PepeTheFroggie/EspCopter32/NewCode/readme.md

Schematic & description see:
https://github.com/PepeTheFroggie/EspCopter32/tree/master

Uses webpage PID setting.

Base for esp32-camcopter with built in wifi FPV. Unfinished.

For UDP transmitter see https://github.com/PepeTheFroggie/ESP32CAM_RCTANK/tree/master/ESP32webCAM_UDP/espnow_UDP_TX

Serial output options:
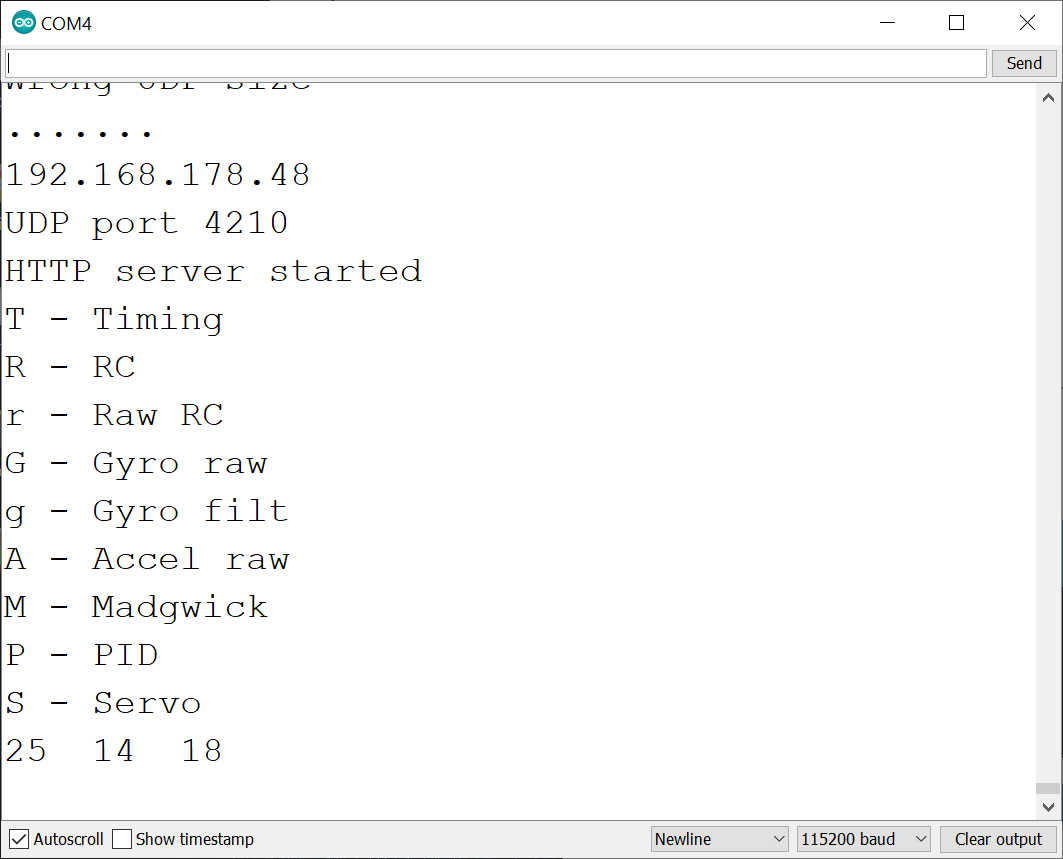
[picture p5: NewCode/serial.png]
serial


Serial Gyro Plot:
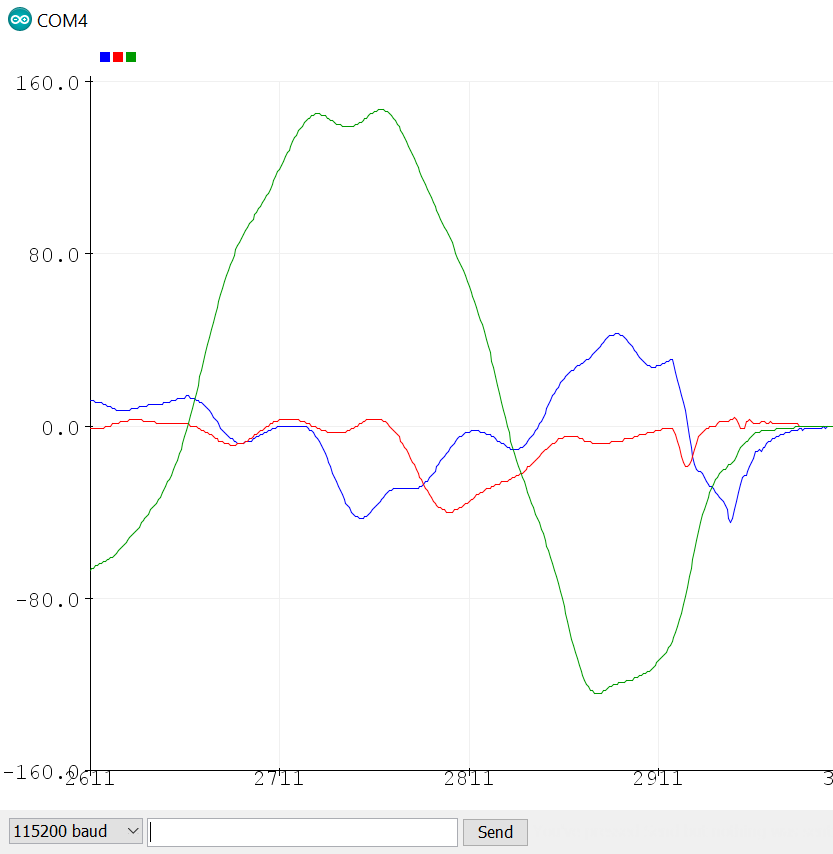
[picture p6: NewCode/gyroplot.png]
gyro


Webbased PID settings:
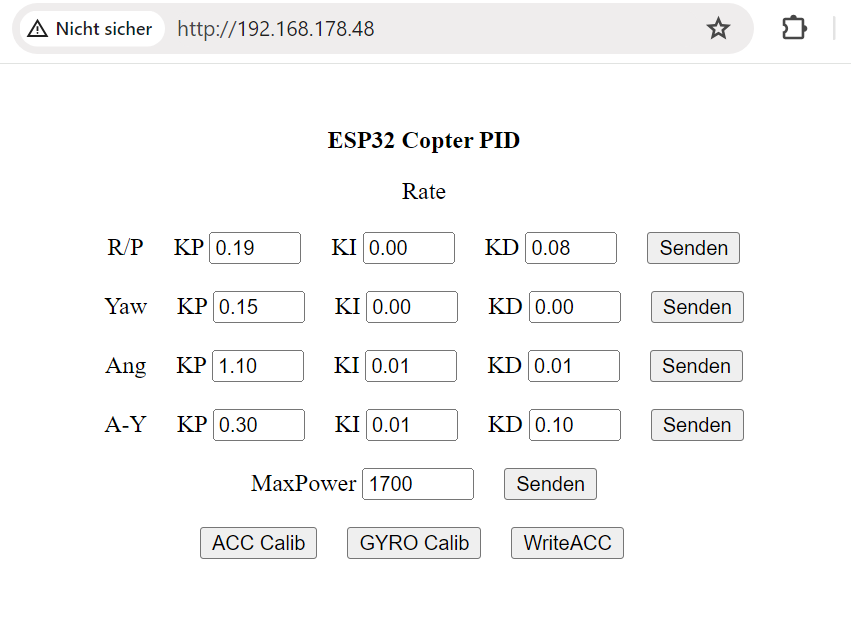
[picture p7: NewCode/web.png]
Web
