PepeTheFroggie/EspCopter32/DSC02375.jpg

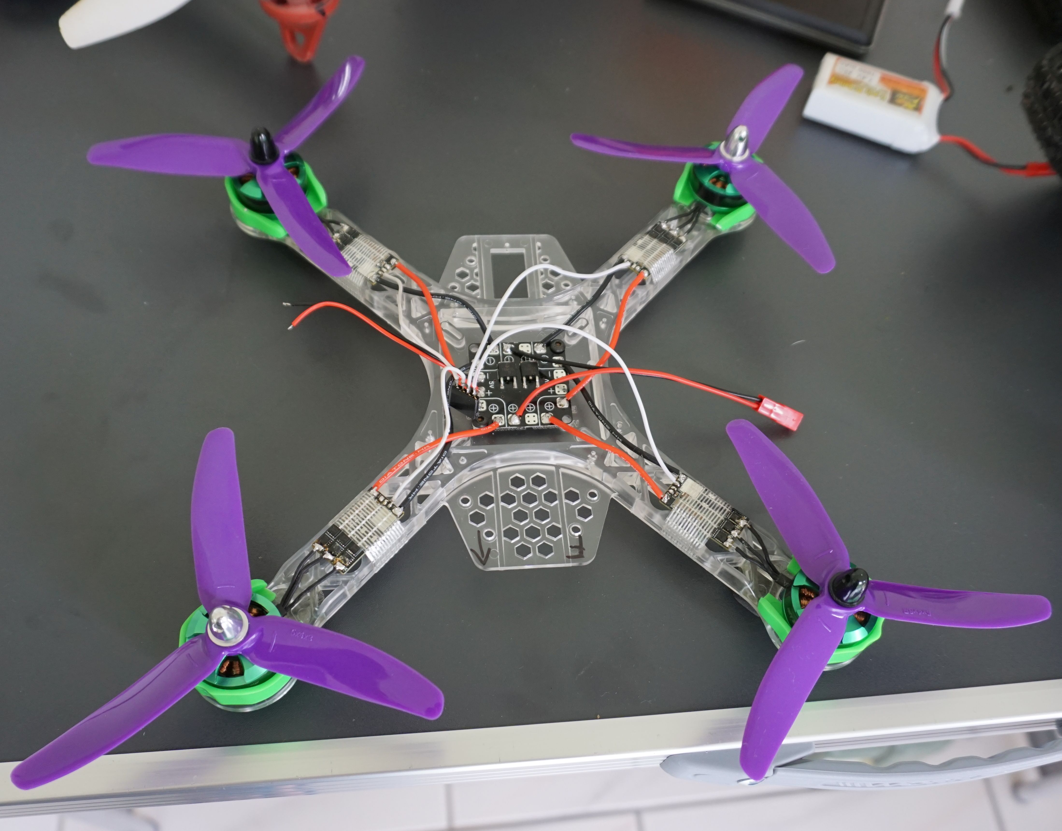
DSC02375.jpg
