PepeTheFroggie/EspCopter32/(threads)

Thread 2 (2020-01-01):

compiling issue

parthasarathy0077, 2020-01-01:
I'm a complete noob. I'm having a hard time in compiling in arduino IDE. Help out..

PepeTheFroggie, 2022-12-22:
No

Closed 2022-12-22.
