PepeTheFroggie/EspCopter32/NewCode/MPU6050.ino

#include <Wire.h>

#define MPU6050_ADDRESS 0x68 
  #define SMPLRT_DIV 0
  #define DLPF_CFG   4

#define ACCRESO 4096
int16_t gyroADC[3];
int16_t accADC[3];

#define ACC_ORIENTATION(X, Y, Z)  {accADC[PITCH] = -X; accADC[ROLL]   = Y;  accADC[YAW]  =  Z;}
#define GYRO_ORIENTATION(X, Y, Z) {gyroADC[ROLL] =  Y; gyroADC[PITCH] = -X; gyroADC[YAW] = -Z;}

void i2cRead(uint8_t Address, uint8_t Register, uint8_t Nbytes, uint8_t* Data) 
{
  Wire.beginTransmission(Address);
  Wire.write(Register);
  Wire.endTransmission();

  Wire.requestFrom(Address, Nbytes);
  uint8_t index=0;
  while (Wire.available())
    Data[index++]=Wire.read();
}

void i2cWriteByte(uint8_t Address, uint8_t Register, uint8_t Data) 
{
  Wire.beginTransmission(Address);
  Wire.write(Register);
  Wire.write(Data);
  Wire.endTransmission();
}

#define ADDRESS 0x03
int calibratingG = CALSTEPS;
int calibratingA = 0;
int16_t gyroZero[3] = {0,0,0};
int16_t accZero[3] = {0,0,0};

// ****************
// GYRO common part
// ****************
void GYRO_Common() 
{
  static int32_t g[3];
  uint8_t axis, tilt=0;

  if (calibratingG>0) 
  {
    for (axis = 0; axis < 3; axis++) 
    {
      // Reset g[axis] at start of calibration
      if (calibratingG == CALSTEPS) g[axis]=0;
      // Sum up 512 readings
      g[axis] += gyroADC[axis];
      // Clear global variables for next reading
      gyroADC[axis]=0;
      gyroZero[axis]=0;
      if (calibratingG == 1) 
      {
        if (g[axis]>=0) g[axis] += CALSTEPS/2;
        else            g[axis] -= CALSTEPS/2;
        gyroZero[axis] = g[axis]/CALSTEPS;
        Serial.print(gyroZero[axis]); 
        if (axis==2) Serial.println(); 
        else         Serial.print("  ");
      }
    }
    calibratingG--;
  }

  for (axis = 0; axis < 3; axis++)
    gyroADC[axis] = gyroADC[axis] - gyroZero[axis];
}

// ****************
// ACC common part
// ****************

void readacc()
{
  accZero[0] = EEPROM.readShort(0);
  accZero[1] = EEPROM.readShort(2);
  accZero[2] = EEPROM.readShort(6);  
}
void storeacc()
{
  EEPROM.writeShort(0, accZero[0]);
  EEPROM.writeShort(2, accZero[1]);
  EEPROM.writeShort(6, accZero[2]);
  EEPROM.commit();      
}

void ACC_Common() 
{
  static int32_t a[3];
  
  if (calibratingA>0) 
  {
    for (uint8_t axis = 0; axis < 3; axis++) 
    {
      // Reset a[axis] at start of calibration
      if (calibratingA == CALSTEPS) a[axis]=0;
      // Sum up 512 readings
      a[axis] += accADC[axis];
      // Clear global variables for next reading
      accADC[axis]=0;
      accZero[axis]=0;
    }
    // Calculate average, shift Z down by acc_1G and store values in EEPROM at end of calibration
    if (calibratingA == 1) 
    {
      if (a[0] >= 0) a[0] += CALSTEPS/2; else a[0] -= CALSTEPS/2;
      if (a[1] >= 0) a[1] += CALSTEPS/2; else a[1] -= CALSTEPS/2;
      if (a[2] >= 0) a[2] += CALSTEPS/2; else a[2] -= CALSTEPS/2;
      accZero[0] = a[0]/CALSTEPS;
      accZero[1] = a[1]/CALSTEPS;
      accZero[2] = a[2]/CALSTEPS - ACCRESO;   
      Serial.print(accZero[0]); Serial.print("  "); 
      Serial.print(accZero[1]); Serial.print("  "); 
      Serial.print(accZero[2]); Serial.println();
    }
    calibratingA--;
  }
  accADC[0] -=  accZero[0];
  accADC[1] -=  accZero[1];
  accADC[2] -=  accZero[2];
}

uint8_t rawADC[14];

void GyroAcc_getADC ()
{
  // 0x3B=6 gyro, 0x41=2 temp, 0x43=6 acc
  i2cRead(MPU6050_ADDRESS, 0x3B,14,rawADC);
  ACC_ORIENTATION( ((rawADC[0]<<8) | rawADC[1]) ,
                   ((rawADC[2]<<8) | rawADC[3]) ,
                   ((rawADC[4]<<8) | rawADC[5]) );
  ACC_Common();
  GYRO_ORIENTATION( ((rawADC[ 8]<<8) | rawADC[ 9]) , 
                    ((rawADC[10]<<8) | rawADC[11]) ,
                    ((rawADC[12]<<8) | rawADC[13]) );
  GYRO_Common();
}

void MPU6050_readId() 
{
  uint8_t id;
  i2cRead(MPU6050_ADDRESS, 0x75, 1, &id);
  if (id == 0x68) Serial.println("6050 ID OK");
  else Serial.println("6050 ID Failed");
}

void MPU6050_init()
{
  Wire.begin();
  Wire.setClock(600000); // orig 400000

  //Gyro_init
  i2cWriteByte(MPU6050_ADDRESS, 0x6B, 0x80);             //PWR_MGMT_1    -- DEVICE_RESET 1
  delay(50);
  
  i2cWriteByte(MPU6050_ADDRESS, 0x6B, 0x03);             //PWR_MGMT_1    -- SLEEP 0; CYCLE 0; TEMP_DIS 0; CLKSEL 3 (PLL with Z Gyro reference)
  i2cWriteByte(MPU6050_ADDRESS, 0x1A, DLPF_CFG);         //CONFIG        -- EXT_SYNC_SET 0 (disable input pin for data sync) ; default DLPF_CFG = 0 => ACC bandwidth = 260Hz  GYRO bandwidth = 256Hz)
  i2cWriteByte(MPU6050_ADDRESS, 0x1B, 0x18);             //GYRO_CONFIG   -- FS_SEL = 3: Full scale set to 2000 deg/sec
  delay(50);
  
  //ACC_init 
  i2cWriteByte(MPU6050_ADDRESS, 0x1C, 0x10);             //ACCEL_CONFIG 
  delay(50);
}
