PepeTheFroggie/EspCopter32/(commit log)

2019-06-20 initial, not flown yet
2019-06-23 better pid, better calibration, pid stored in eeprom
